ETML-ES-SLO/PRJ_2407_CmdFrigo/doc/Annexes/Annexe B/2707_Planification.pdf

Tâches | Détails

Cahier des charges et planification

Pré-étude | Choix de la gache

Gestion des affichages

Choix du microcontrôleur

Choix des modules wifi et ehternet

Choix de l'affichage

Choix du module RFID

Schéma électrique

PCB

Boîtier

Software | Renseignements

Estimation de la consommation

Assemblage

Tests et mise au point

Rédaction du rapport

Commande de la gache

Lecture badge RFID

Communication Wi-Fi

Lecture batterie

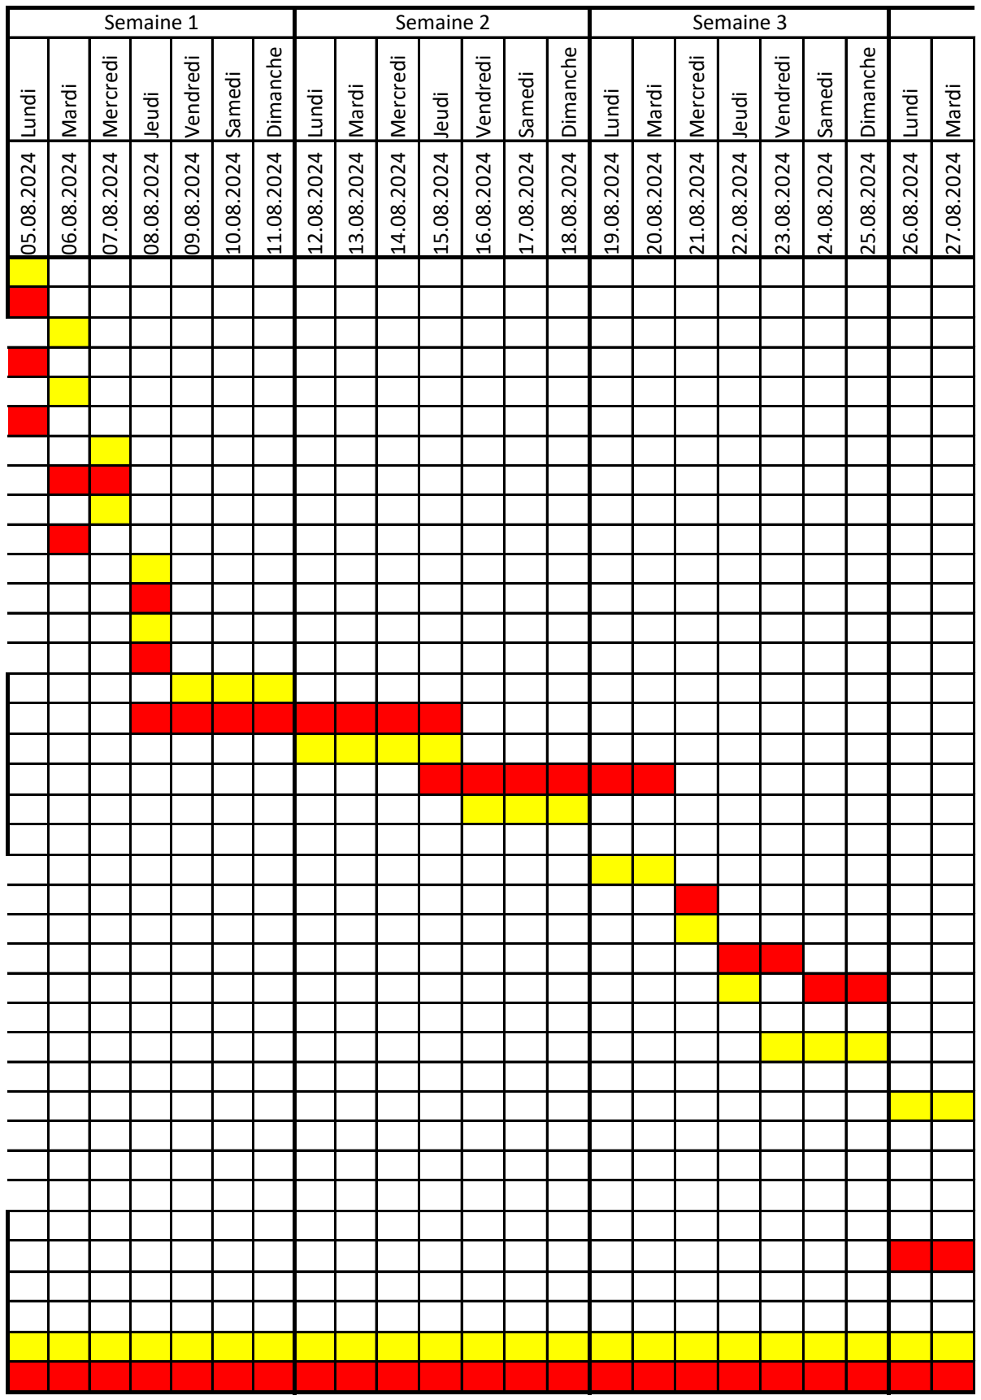
[picture p1: figure]
Lundi; Mardi; Mercredi; Jeudi; Vendredi; Samedi; Dimanche; Semaine 1; Semaine 2; Semaine 3

Réalisé

Planifié

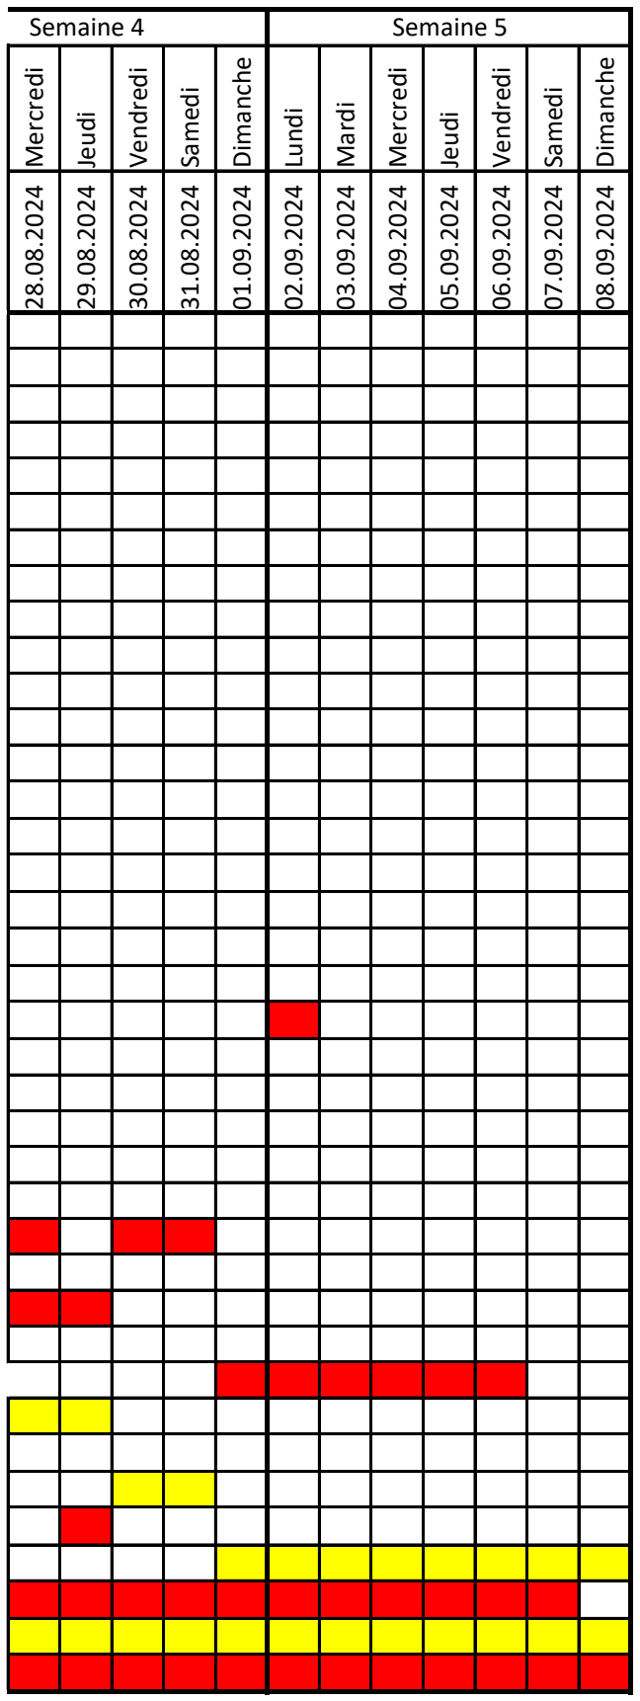
[picture p2: figure]
Mercredi; Jeudi; Vendredi; Samedi; Dimanche; Lundi; Mardi; Semaine 4; Semaine 5
