ETML-ES-SLO/PRJ_2407_CmdFrigo/doc/Annexes/Annexe D/PV_210824 .pdf

PV de séance | diplôme

Ecole supérieure, école des métiers Lausanne
Rue de Sébeillon 12
CH-1004 Lausanne | www.etml.ch
PV_210824 .docx | | 1 / 2 |

## Procès-verbal du 21.08.2024

Présents

- | M. Bovey | (PBY)
- | M. Do Carmo | (ADC)

État des lieux

- Revue de PCB effectuée Lundi 19.08.2024
- Design du PCB fini :
- Corrections sur le schéma (driver de gate ajouté + alim 3,3V corrigée)
- BOM finie
- Commande des composants effectuée
- Commande du PCB effectuée
- Rapport :
- Pré-étude finie
- Schéma presque fini

Problèmes rencontrés

- Rapport :
- Question sur le ratio pour la fin de charge de l’accu
- Pourquoi des résistances 5k1 sur l’USB-C ? Norme ?

Solutions proposées

Décisions prises

- Rapport :
- La tension de l'accu a atteint sa tension nominal - système de limitation du courant - car l'accu se charge que le courant décroit
- Documentation (https://www.microchip.com/content/dam/mchp/documents/OTH/ApplicationNotes/ApplicationNotes/00001914B.pdf) sur l’USB-C trouvée

Suite du projet / objectifs - jusqu’au 28 août

- Structogrammes et machine d’état
- Réaliser le pining du microcontrôleur
- Paramétrer les différents drivers
- Importer les librairies
- Commencer le code

ETML⁻ES

PV_210824 .docx | 30.08.2024 - page 2 / 2

Prochaine réunion:

23.08.2024, 11h30, Salle R110 ETML-ES | Revue code
28.08.2024, 09h00, Salle R110 ETML-ES | Séance classique

Destinataires de ce PV

- Grégoire Rossier, Doyen de l’ETML-ES
- Philippe Bovey, Maître de diplôme

Lausanne le 22.08.2024

Antonio Do Carmo
