ETML-ES-SLO/PRJ_2407_CmdFrigo/doc/Annexes/Annexe D/PV_300824 .pdf

PV de séance | diplôme

Ecole supérieure, école des métiers Lausanne
Rue de Sébeillon 12
CH-1004 Lausanne | www.etml.ch
PV_300824 .docx | | 1 / 2 |

## Procès-verbal du 30.08.2024

Présents

- | M. Bovey | (PBY)
- | M. Do Carmo | (ADC)

État des lieux

- Début du code :
- Pining et configuration
- Diagramme d’états
- Fonction lecture de la batterie
- Fonction ouverture de la gâche
- PCB reçu et assemblé
- Rapport :
- Pré-étude finie
- Schéma fini

Problèmes rencontrés

- Support d’accu pas adapté

Solutions proposées

- Commencer le soft en alimentant via l’alim de labo

Décisions prises

Suite du projet / objectifs - jusqu’au 4 septembre

- Structogrammes et amélioration machine d’état
- Finaliser le code (RFID, Wi-Fi, I/O Expander, …)
- Concevoir le boîtier

Prochaine réunion:

02.09.2024, 11h30, Salle R110 ETML-ES | Revue code
04.08.2024, 09h00, Salle R110 ETML-ES | Séance classique

ETML⁻ES

PV_300824 .docx | 03.09.2024 - page 2 / 2

Destinataires de ce PV

- Grégoire Rossier, Doyen de l’ETML-ES
- Philippe Bovey, Maître de diplôme

Lausanne le 28.08.2024

Antonio Do Carmo
