ETML-ES-SLO/PRJ_2407_CmdFrigo/doc/Annexes/Annexe J/Mode d'emploi.pdf

## Ecole supérieure

Électronique

ETML-ES
Salle R110

# Diplôme - 2407 Commande Ouverture Frigo

# Mode d’emploi

Réalisé par :

Antonio Do Carmo

Étape 1 :

Insérer les accumulateurs dans le support prévu à cet effet

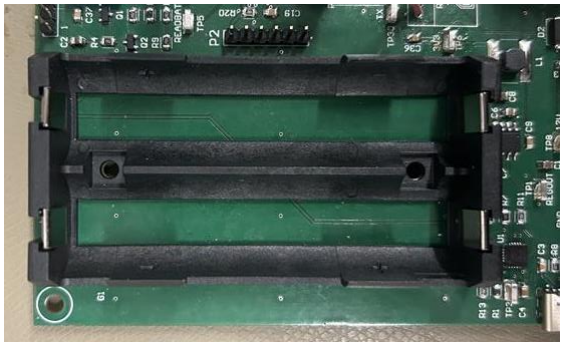
[picture p3: figure]

Étape 2 :

Brancher le module RFID, le LCD et la gâche au circuit

Étape 3 :

Refermer le boîtier

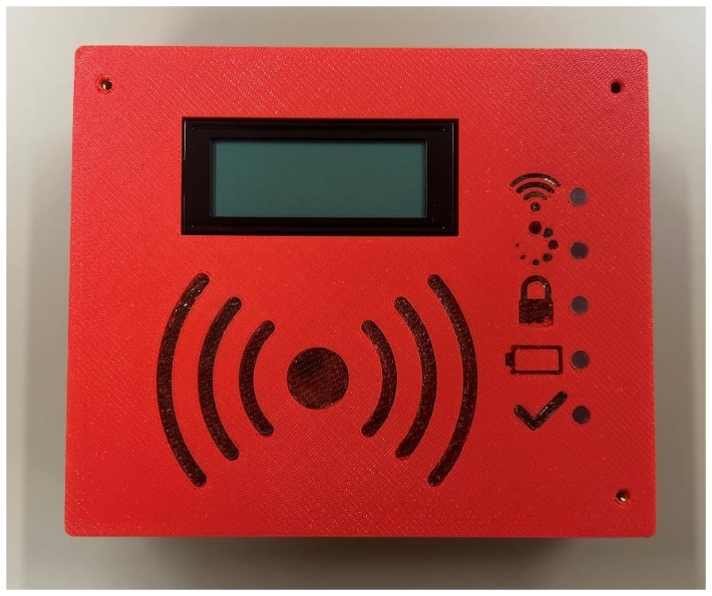
[picture p4: figure]

Étape 4 :

Placer le boîtier et la gâche sur la porte du frigo

Étape 5 :

Passer le badge RFID sur la surface du boîtier comportant le logo RFID afin d’ouvrir la porte
