ETML-ES-SLO/PRJ_2407_CmdFrigo/doc/Annexes/Annexe H/Schéma de mesures diplôme.png

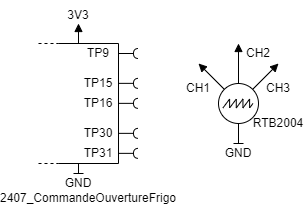
doc/Annexes/Annexe H/Schéma de mesures diplôme.png
