ETML-ES-SLO/PRJ_2407_CmdFrigo/doc/Annexes/Annexe L/duree gache.png

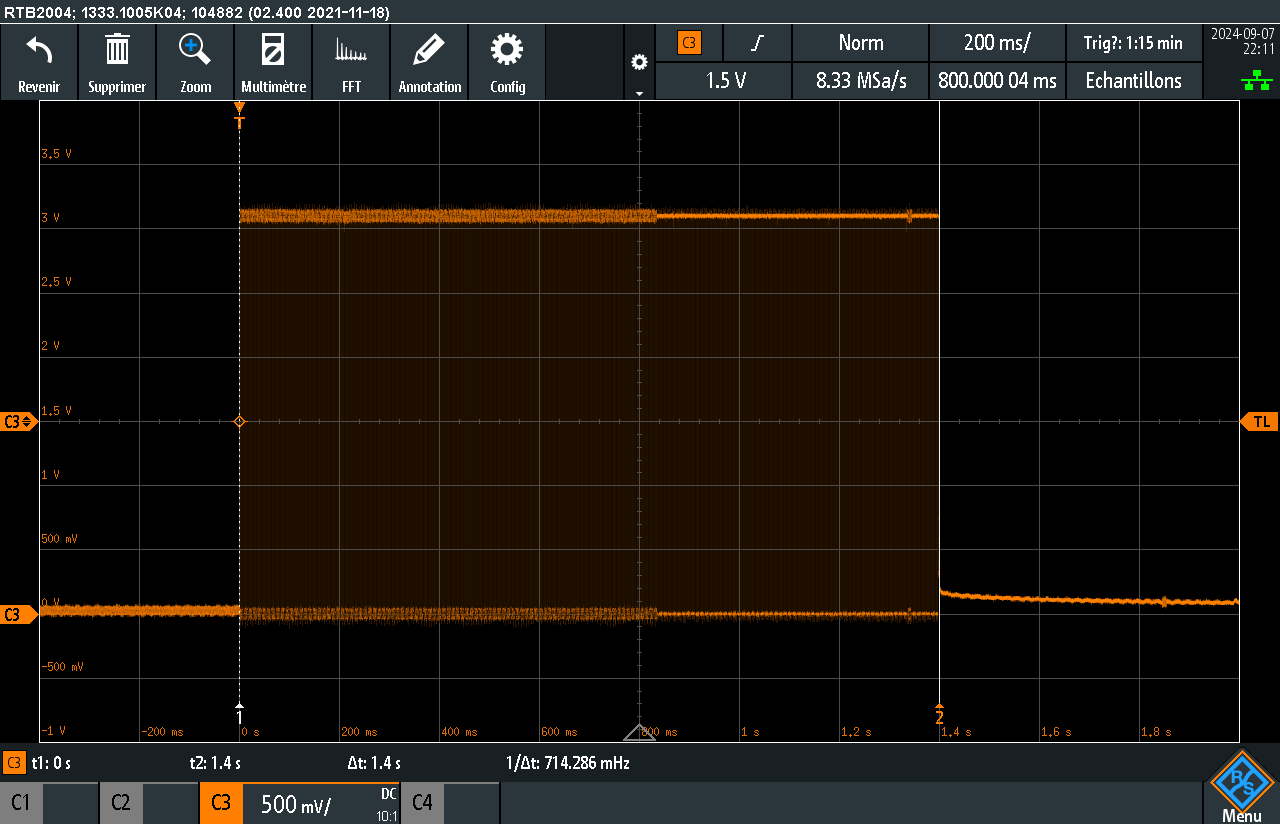
doc/Annexes/Annexe L/duree gache.png
