ETML-ES-SLO/PRJ_2407_CmdFrigo/doc/Annexes/Annexe L/gache 3V5.png

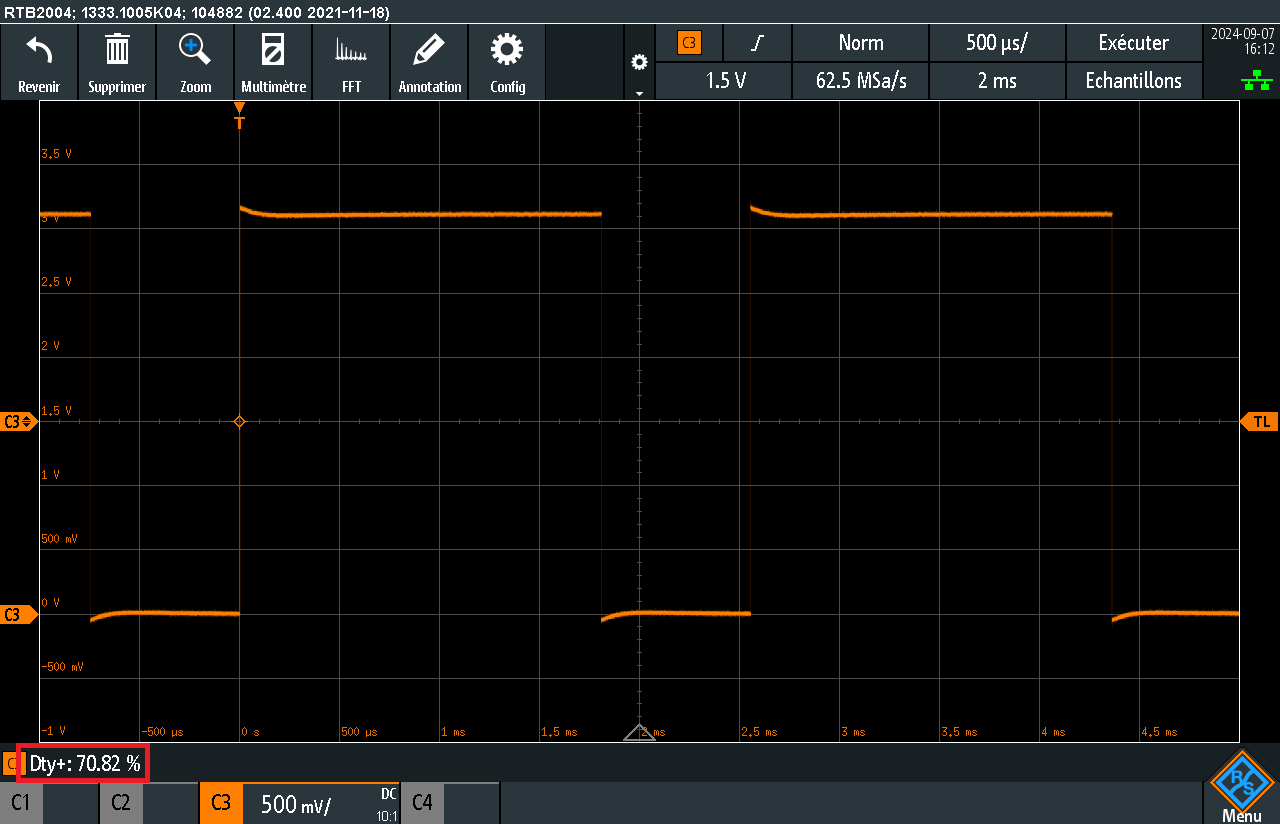
doc/Annexes/Annexe L/gache 3V5.png
