ETML-ES-SLO/PRJ_2407_CmdFrigo/doc/Annexes/Annexe L/I2C.png

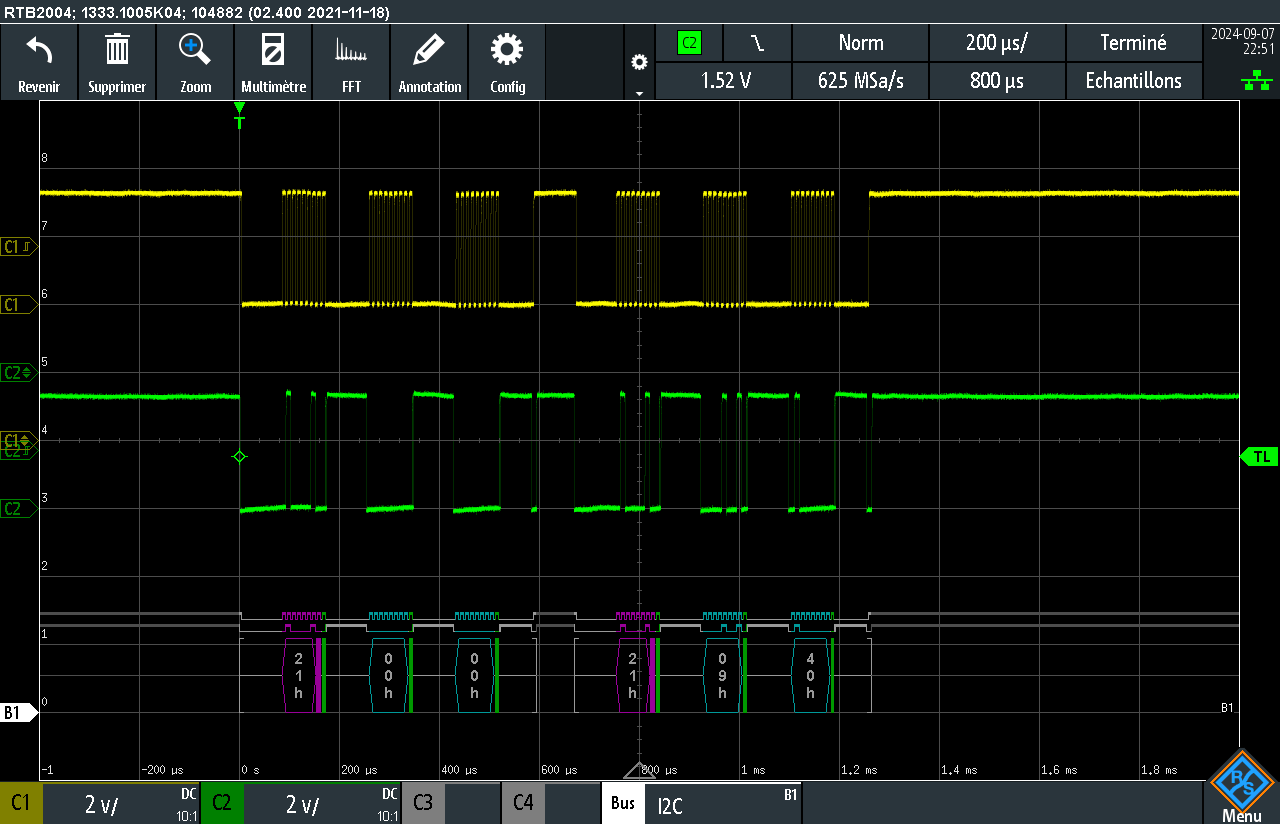
doc/Annexes/Annexe L/I2C.png
