ETML-ES-SLO/PRJ_2407_CmdFrigo/doc/Annexes/Annexe L/Polling.png

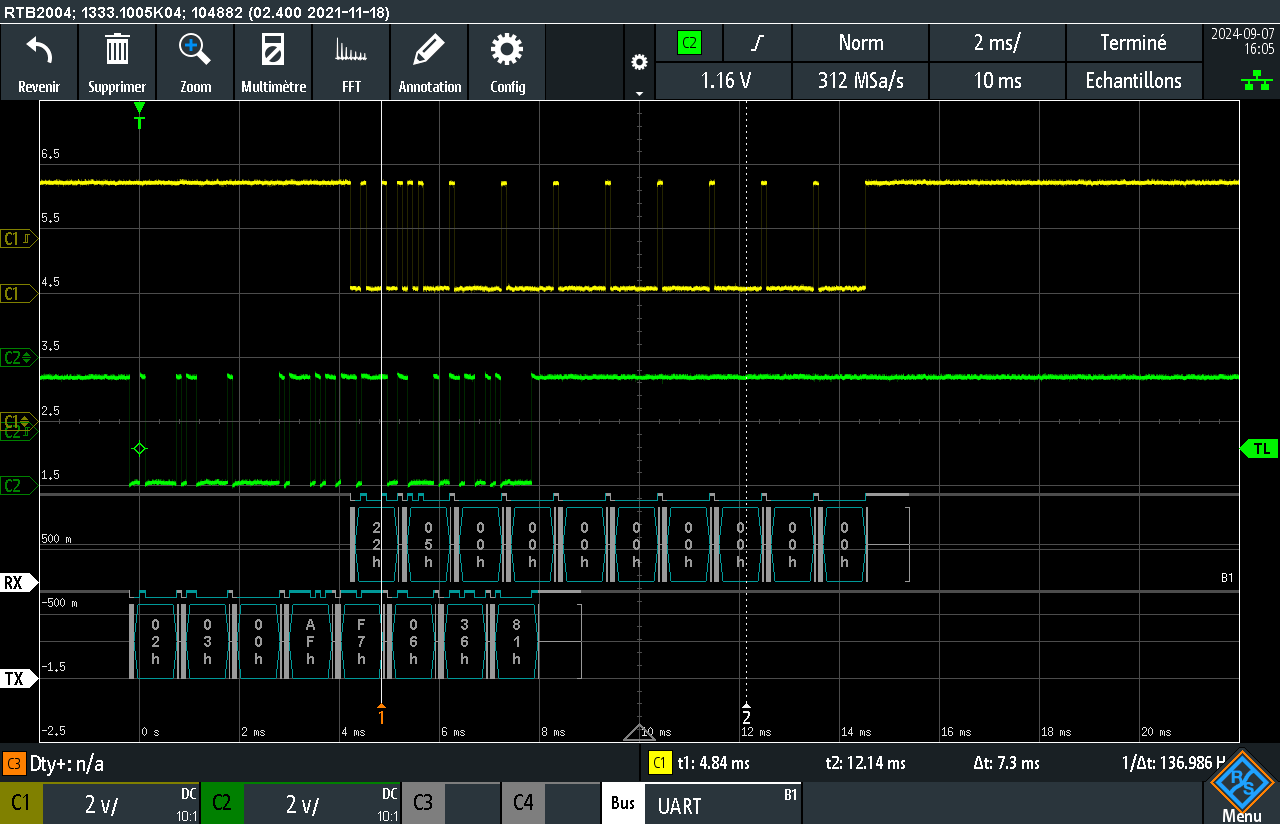
doc/Annexes/Annexe L/Polling.png
