ETML-ES-SLO/PRJ_2407_CmdFrigo/doc/Annexes/Annexe L/RFID_UID.png

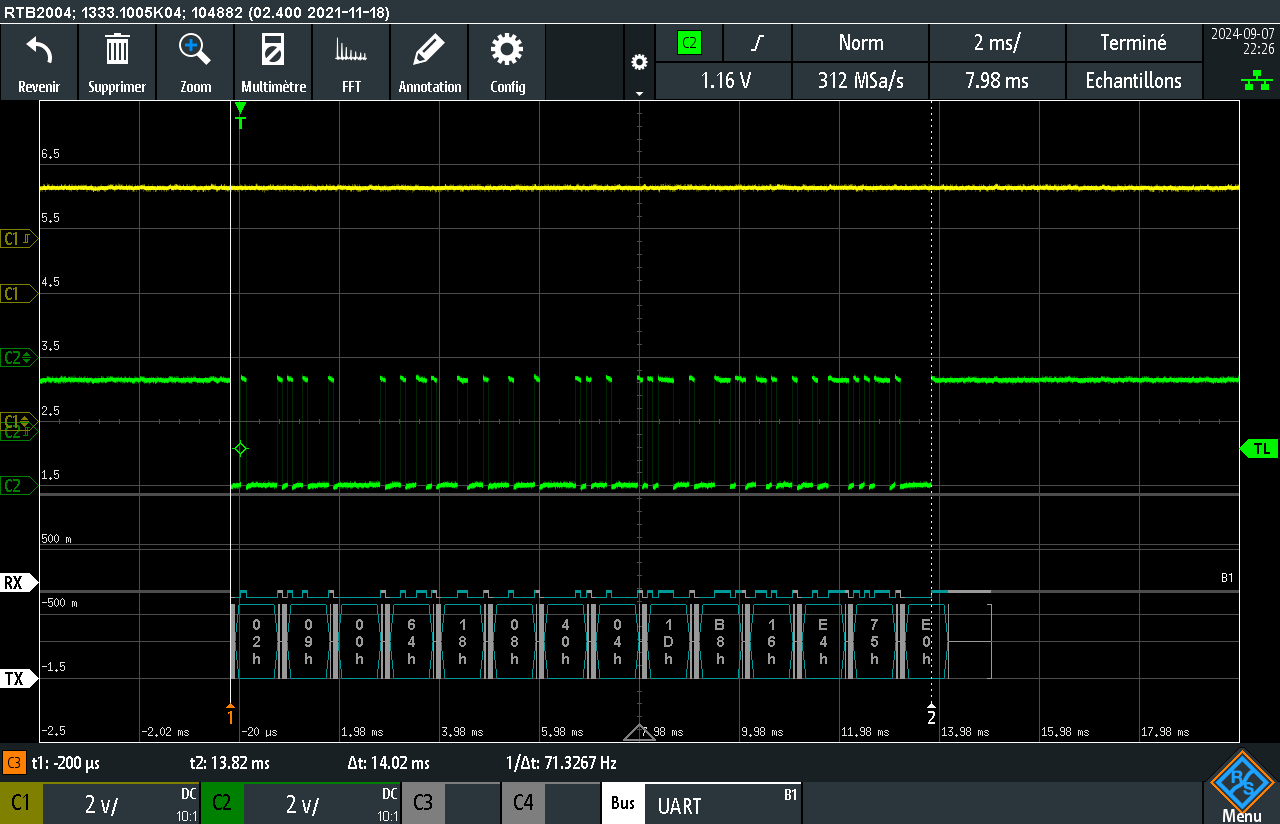
doc/Annexes/Annexe L/RFID_UID.png
