ETML-ES-SLO/PRJ_2407_CmdFrigo/mec/Couvercle boitier.SLDPRT

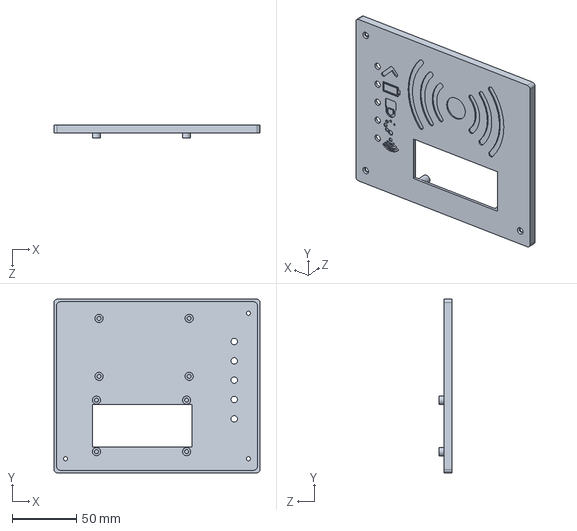
[picture p11: CAD file, 2024-09-09]
mec/Couvercle boitier.SLDPRT
160.0 x 135.0 x 10.0 mm
