ETML-ES-SLO/PRJ_2407_CmdFrigo/mec/NHD-0420AZ.STEP

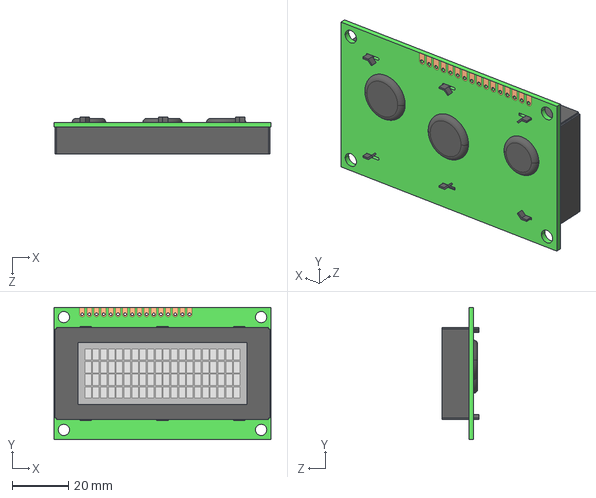
[picture p12: CAD file, 2024-09-09]
mec/NHD-0420AZ.STEP
77.0 x 47.0 x 13.0 mm
