ETML-ES-SLO/PRJ_2407_CmdFrigo/mec/Boitier base.SLDPRT

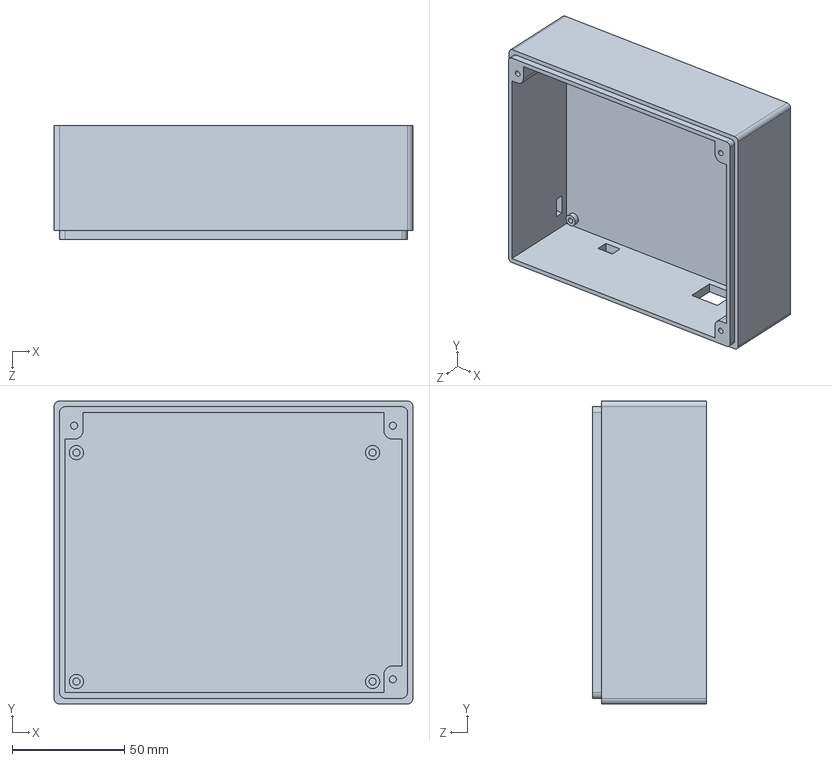
[picture p13: CAD file, 2024-09-09]
mec/Boitier base.SLDPRT
160.0 x 135.0 x 51.0 mm
