ETML-ES-SLO/PRJ_2407_CmdFrigo/mec/iso_2009_m3_x_20.SLDPRT

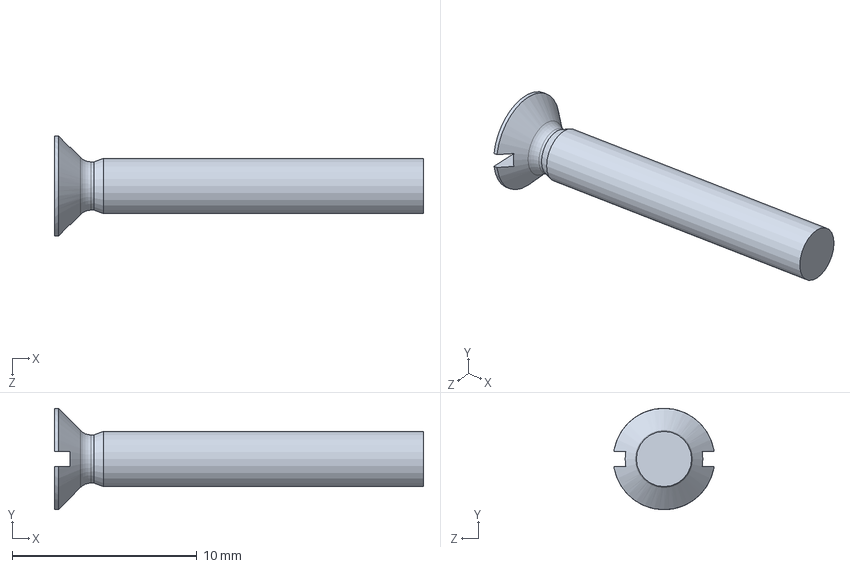
[picture p14: CAD file, 2024-09-09]
mec/iso_2009_m3_x_20.SLDPRT
20.0 x 5.50 x 5.44 mm
