ETML-ES-SLO/PRJ_2407_CmdFrigo/mec/1474370.SLDPRT

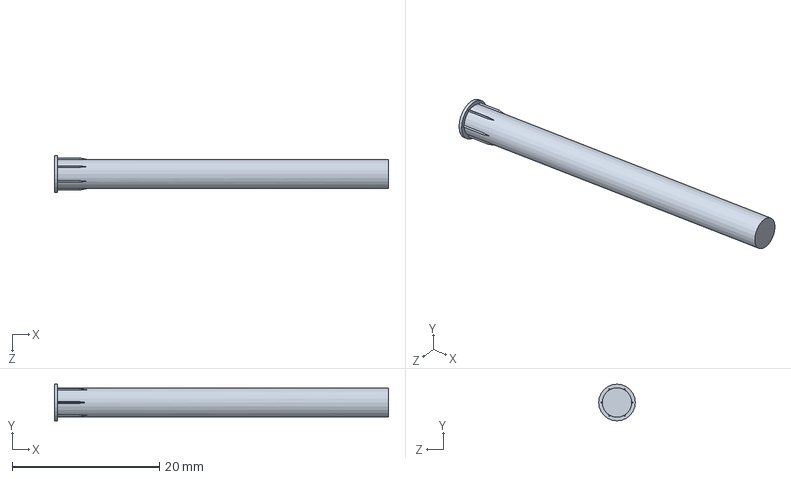
[picture p15: CAD file, 2024-09-09]
mec/1474370.SLDPRT
45.4 x 5.00 x 5.00 mm
