ETML-ES-SLO/PRJ_2407_CmdFrigo/(list of files, cad)

Other CAD files:
mec/Boitier base.SLDDRW
mec/Couvercle boitier.SLDDRW
