ETML-ES-SLO/PRJ_2407_CmdFrigo/doc/Annexes/Annexe C/2407_Journal_de_travail.pdf

Date | Début | Fin | Durée
05.08.2024 | 10h00 | 11h15 | 1h15
05.08.2024 | 11h15 | 11h50 | 0h35
05.08.2024 | 11h50 | 12h00 | 0h10
05.08.2024 | 12h50 | 13h50 | 1h00
05.08.2024 | 13h50 | 14h10 | 0h20
05.08.2024 | 14h10 | 14h20 | 0h10
05.08.2024 | 14h20 | 14h40 | 0h20
05.08.2024 | 14h40 | 15h30 | 0h50
05.08.2024 | 15h30 | 19h00 | 3h30
05.08.2024 | 19h00 | 20h00 | 1h00
06.08.2024 | 8h40 | 9h40 | 1h00
06.08.2024 | 9h40 | 10h00 | 0h20
06.08.2024 | 10h00 | 10h20 | 0h20
06.08.2024 | 10h20 | 11h30 | 0h50
06.08.2024 | 12h30 | 14h10 | 1h40
06.08.2024 | 14h10 | 14h30 | 0h20
06.08.2024 | 14h30 | 15h30 | 1h00
06.08.2024 | 15h30 | 16h10 | 0h40
06.08.2024 | 16h10 | 17h00 | 0h50
07.08.2024 | 8h30 | 10h00 | 1h30
07.08.2024 | 10h00 | 10h40 | 0h40
07.08.2024 | 10h40 | 11h00 | 0h20
07.08.2024 | 11h00 | 11h30 | 0h30
07.08.2024 | 13h00 | 13h20 | 0h20
07.08.2024 | 13h20 | 16h30 | 3h10
07.08.2024 | 16h30 | 17h20 | 0h50
07.08.2024 | 17h20 | 18h20 | 1h00
07.08.2024 | 18h20 | 19h00 | 0h40
08.08.2024 | 8h45 | 10h00 | 1h15
08.08.2024 | 10h00 | 11h30 | 1h30
08.08.2024 | 12h20 | 14h10 | 1h50

08.08.2024 | 14h10 | 14h50 | 0h40
08.08.2024 | 14h50 | 15h00 | 0h10
08.08.2024 | 15h00 | 18h00 | 3h00
09.08.2024 | 8h40 | 11h30 | 2h50
09.08.2024 | 12h30 | 13h40 | 1h10
09.08.2024 | 13h40 | 16h30 | 2h50
11.08.2024 | 15h00 | 19h00 | 4h00
12.08.2024 | 8h40 | 9h10 | 0h30
12.08.2024 | 9h10 | 10h40 | 1h30
12.08.2024 | 10h40 | 11h40 | 1h00
12.08.2024 | 12h30 | 20h30 | 8h00
13.08.2024 | 8h40 | 9h40 | 1h
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
Design du PCB
Design du PCB
Design du PCB
Design du PCB
Discussion avec M.Moreno
Design du PCB
Software
Software
Software

Software

Software
Software
Schéma électrique
Visite de l'expert

Software

Software

Hardware
Mesures
Hardware
Hardware
Hardware
Software
Discussion avec M.Bovey

Software

Software
Hardware
Software
Software
Software
Discussion avec M.Bovey
Software
Software
Discussion avec M.Bovey
Software
Software
Software
Software
Rapport de projet
Software
Discussion avec M.Bovey
Software
Software
Software
Rapport de projet
Modifications
Software
Mesures
Rapport de projet
Rapport de projet
Rapport de projet
Rapport de projet
Rapport de projet

Détails

Cahier des charges, grille d'évaluation, etc Création du projet Altium
Planification, journal de travail, rapport

Précisions sur le cahier des charges + questions

Planification
Par M.Moreno
Planification

Choix de la gache

Recherche de modules Wi-Fi et Ethernet

Lecture de la documentation sur le RFID

Lecture du rapport du projet 2312

Recherche d'un affichage

Tentative de lecture des badges RFID fournis

Rédaction du rapport avec les composants choisis

Tentative de lecture des badges RFID fournis

Rédaction du rapport avec les composants choisis Préparation du word pour le PV du landemain Rédaction du rapport avec les composants choisis Rédaction de l'introduction du rapport Séance de pré-étude
PV du 07.08.2024
Tableau comparatif des gâches Corrections du PV
Schéma bloc du système

Recherche d'un nouveau LCD

Rédaction des chapitres sur les différents composants Ajout du système de recharge et de lecture de l'accumulateur sur le schéma bloc
Choix du microcontrôleur
Chronogramme ouverture

Estimation de la consommation

Début du schéma électrique
Au sujet de l'estimation de la consommation Blocs microcontrôleur, Alimentation, Affichage Footprints + modèles 3D
Footprints + modèles 3D

Rédaction des chapitres sur les différents composants Rédaction des chapitres sur les différents composants Avec M.Bovey

Finalisation des blocs Wifi, Ethernet, Affichage, Alimentation

Tests de tension et courant sur la gache

Finalisation des blocs Wifi, Ethernet, Affichage, Alimentation

Recherche d'un I/O expander Fin du schéma électrique
Vérifications du schéma avec JAR Ajout des composants sur saphir Corrections du schéma
Début du layout du PCB
Layout du PCB
A propos du Layout
Début du layout du PCB
Fin du layout PCB
Début du routage
Routage du PCB
Routage du PCB
Revue du PCB
Routage du PCB
Routage du PCB
Routage du PCB
Finalisation du PCB
Revue du PCB
Finalisation du PCB et commande Pining et configuration
Lecture de la batterie
Lecture de la batterie

Fonction de lecture de la batterie et d'ouverture de la gâche

Lecture de la doc et des librairies Lecture de la doc et des librairies Avancement sur le rapport de diplôme Séance avec M.Yersin

Fonction de lecture de la batterie et d'ouverture de la gâche

Fonction de lecture de la batterie et d'ouverture de la gâche

Assemblage du PCB
Test de l'alimentation
Assemblage du PCB
Assemblage du PCB
Assemblage du PCB
Tests programmation sur la carte Séance rapide

Fonction de lecture de la batterie et d'ouverture de la gâche

Fonction de lecture de la batterie et d'ouverture de la gâche Câblage du LCD
Fonction pour le LCD
Fonction pour l'I/O Expander Fonction pour l'I/O Expander Séance classique
Fonction pour l'I/O Expander Fonction pour l'I/O Expander Séance rapide
Fonction pour le RFID
Fonction pour le RFID
Fonction pour le RFID
Fonction pour le RFID
Suite du rapport
Fonction pour le RFID
Séance rapide
Fonction pour le RFID
Programmation de l'ESP32
Fonction pour le RFID
Suite du rapport
Modificatios DC-DC12V et assemblage boîtier Fonction pour le RFID
Mesures des différentes trames Suite du rapport
Suite du rapport
Suite du rapport
Suite du rapport
Fin du rapport

Problèmes

1) Possible d'avoir le matériel du TP RFID?
2) Mise à disposition de la glacière?
3) Présence des enseignants?
3) Quand est la 1ère séance, que préparer?

Les gaches magnétiques classiques nécéssitent une grande puissance et sont en fonctionnement permanent
=> Pas possible de les faire fonctionner sur batterie et facilement bypassable en débranchant le boîtier du secteur

Impossible de les lire avec le kit de l'ES et avec des applications dédiées sur smartphone

Voir PV de la séance

Le LCD choisi précédemment doit être alimenté en 5V mais tout le reste de mon circuit fonctionne en 3.3V

Batterie 3400 mAh semble insuffisante => voir avec M.Bovey

Pas assez de pins sur le uC

Inductance trop grosse

ADC illisible

Carte illisible -> badge de l'ES lisible

Solutions

1) Oui (donné)
2) Mercredi lors de la séance
3) Horaires donnés par email
4) Mercredi / canevas PV, planification, avancement

J'ai trouvé ce modèle de gache (https://www.amazon.fr/%C3%89lectronique-%C3%89lectrique-Sol%C3%A9no%C3%AFde-D%C3%A9tection-Interrupteur/dp/B07B4G6N1K)

J'ai trouvé les modules Wifi Click et ETH Click de chez Mikroe

Mon prédécésseur a utilisé les composants suivants:
- LAN8720A-CP-TR-ABC pour l'Ethernet
- ESP32-C3-WROOM-02-N4 pour le Wi-Fi
- CHILLI UART B1 pour le RFID
Un LCD classique devrait faire l'affaire

A l'aide de l'application Tag Reader j'ai pu lire un des deux badges fournis

Voir PV de la séance

J'ai trouvé ce modèle de LCD (https://www.digikey.ch/fr/products/detail/newhaven-display-intl/NHD-0420AZ-FSW-GBW-33V3/2773596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)

Voir PV

Voir PV
J'ai trouvé ce modèle (https://www.mouser.ch/ProductDetail/Microchip-Technology/MCP23008-E-SO?qs=Sez7gRs8XSWum74ZwQXTLw%3D%3D)

Ne pas fixer le LCD et le module RFID au PCB

Alimentation OK

Microcontrôleur fonctionnel

ADC fonctionnel

LCD fonctionnel

I/O Expander fonctionnel

Voir problèmes de timing pour le RFID
