ETML-ES-SLO/PRJ_2407_CmdFrigo/doc/Annexes/Annexe F/2407_Commande_Ouverture_Frigo_PCB Top-Bot Assy Dwgs_Variant_No Variations.PDF

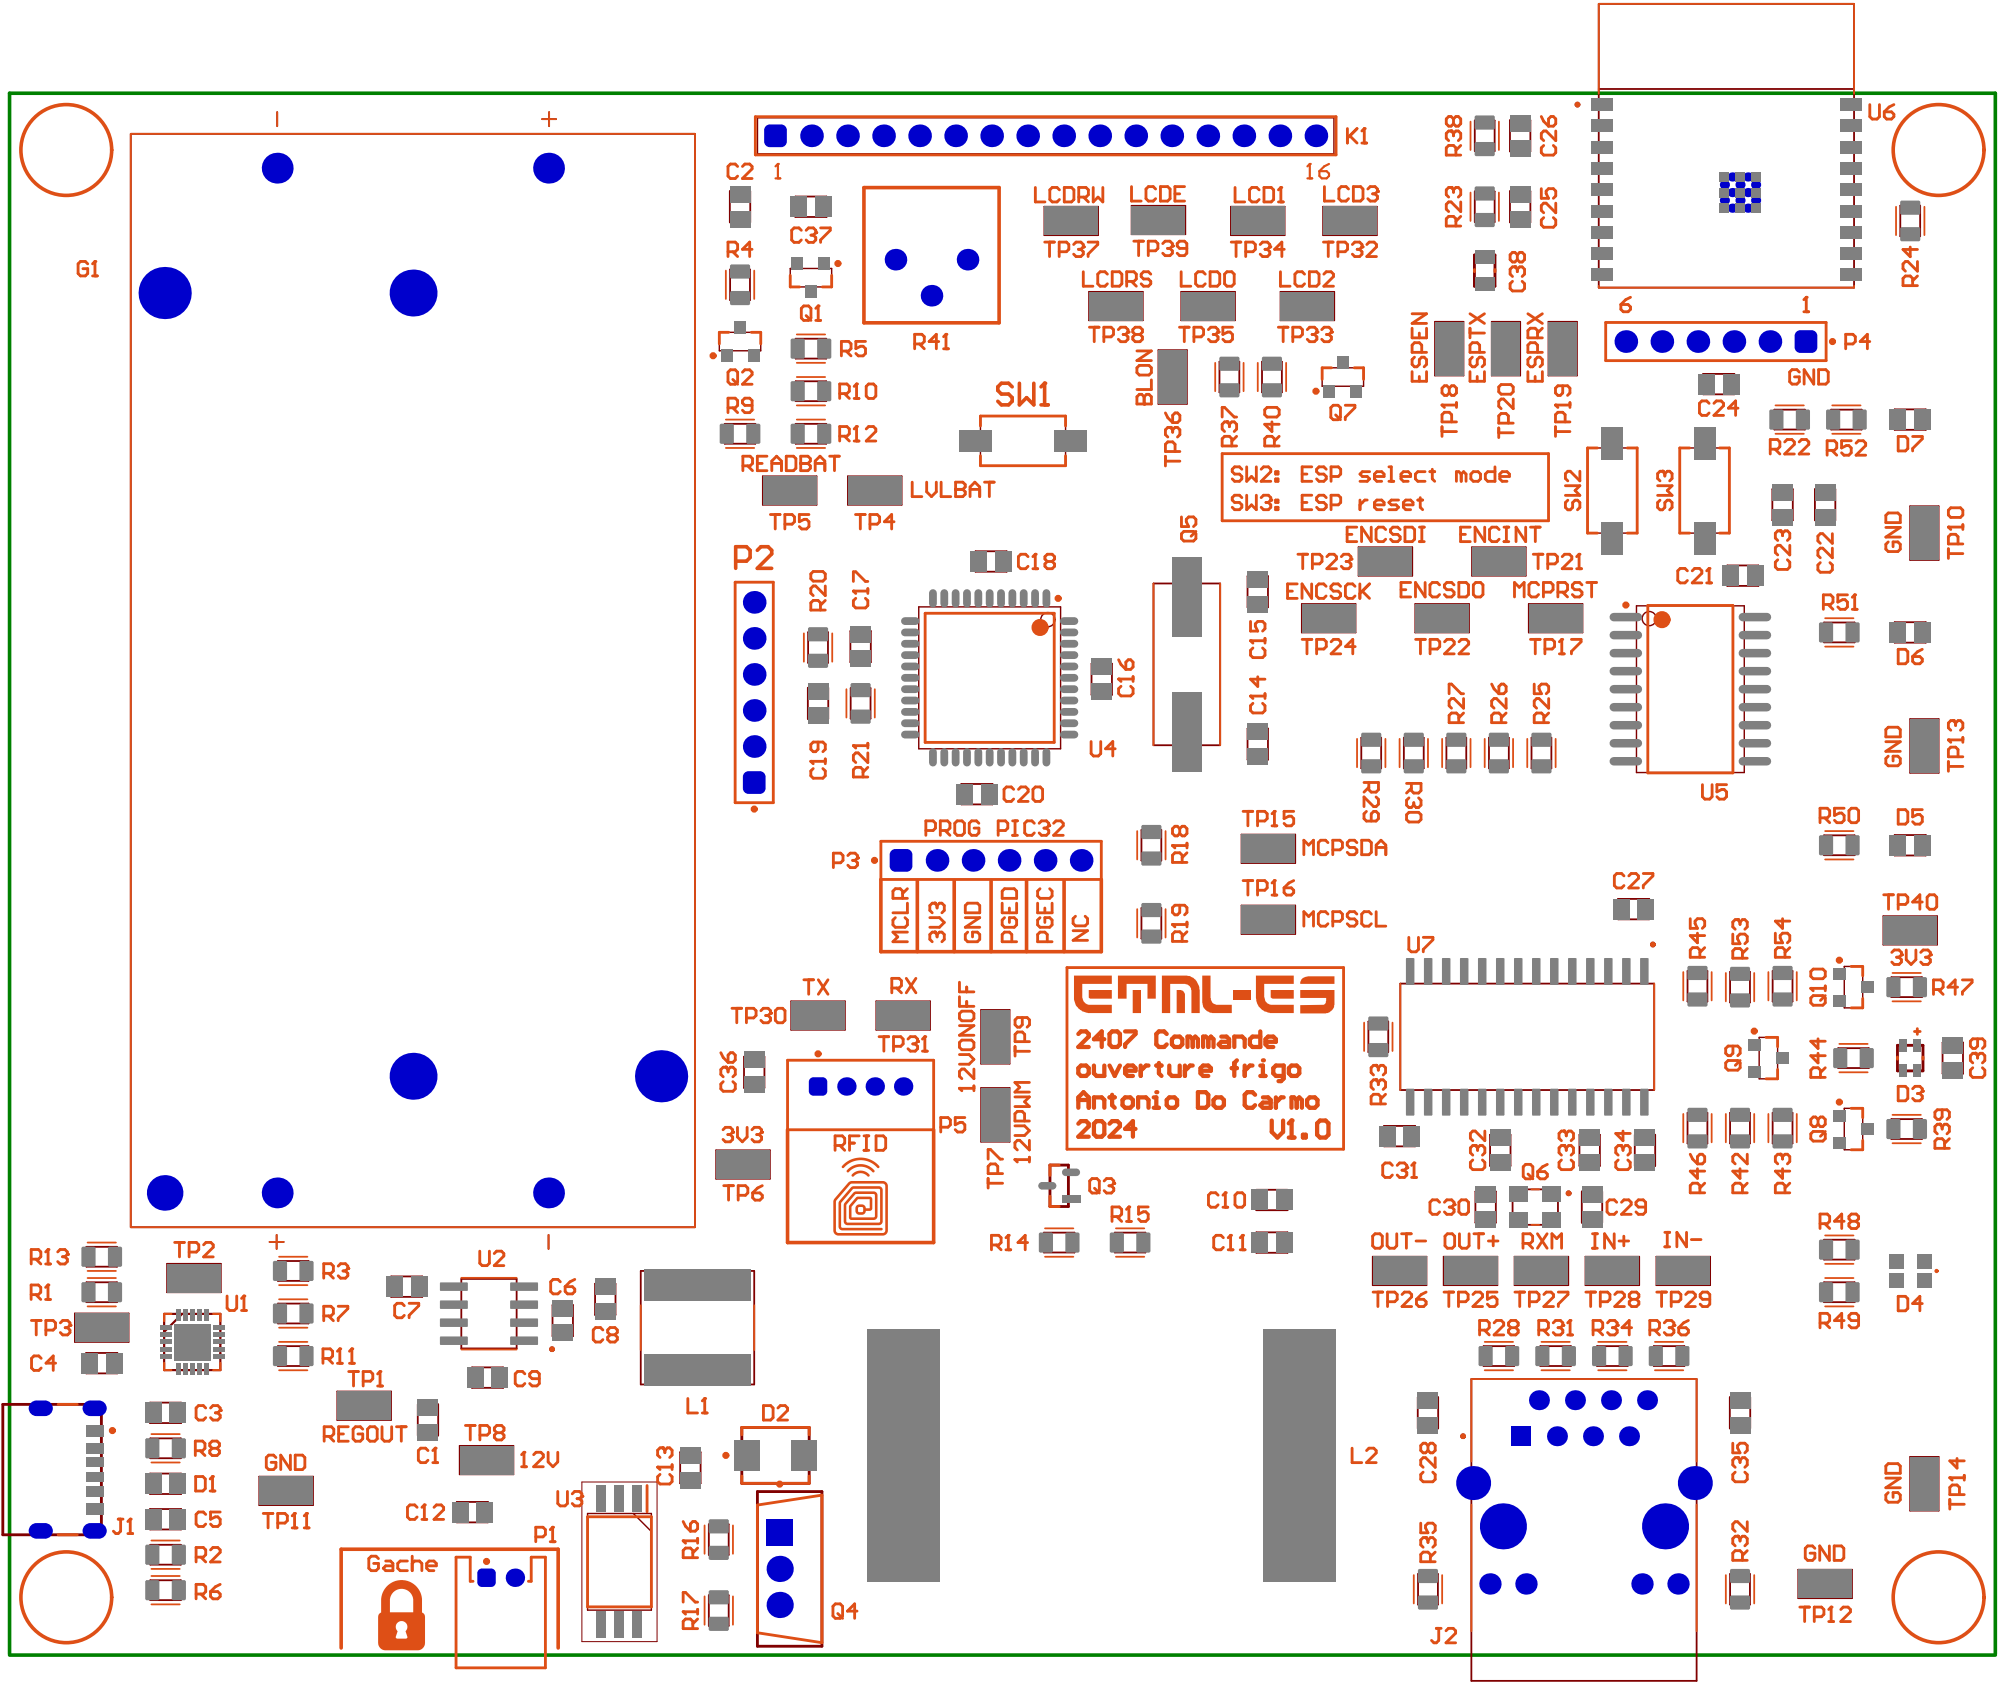
[picture p20: page 1]
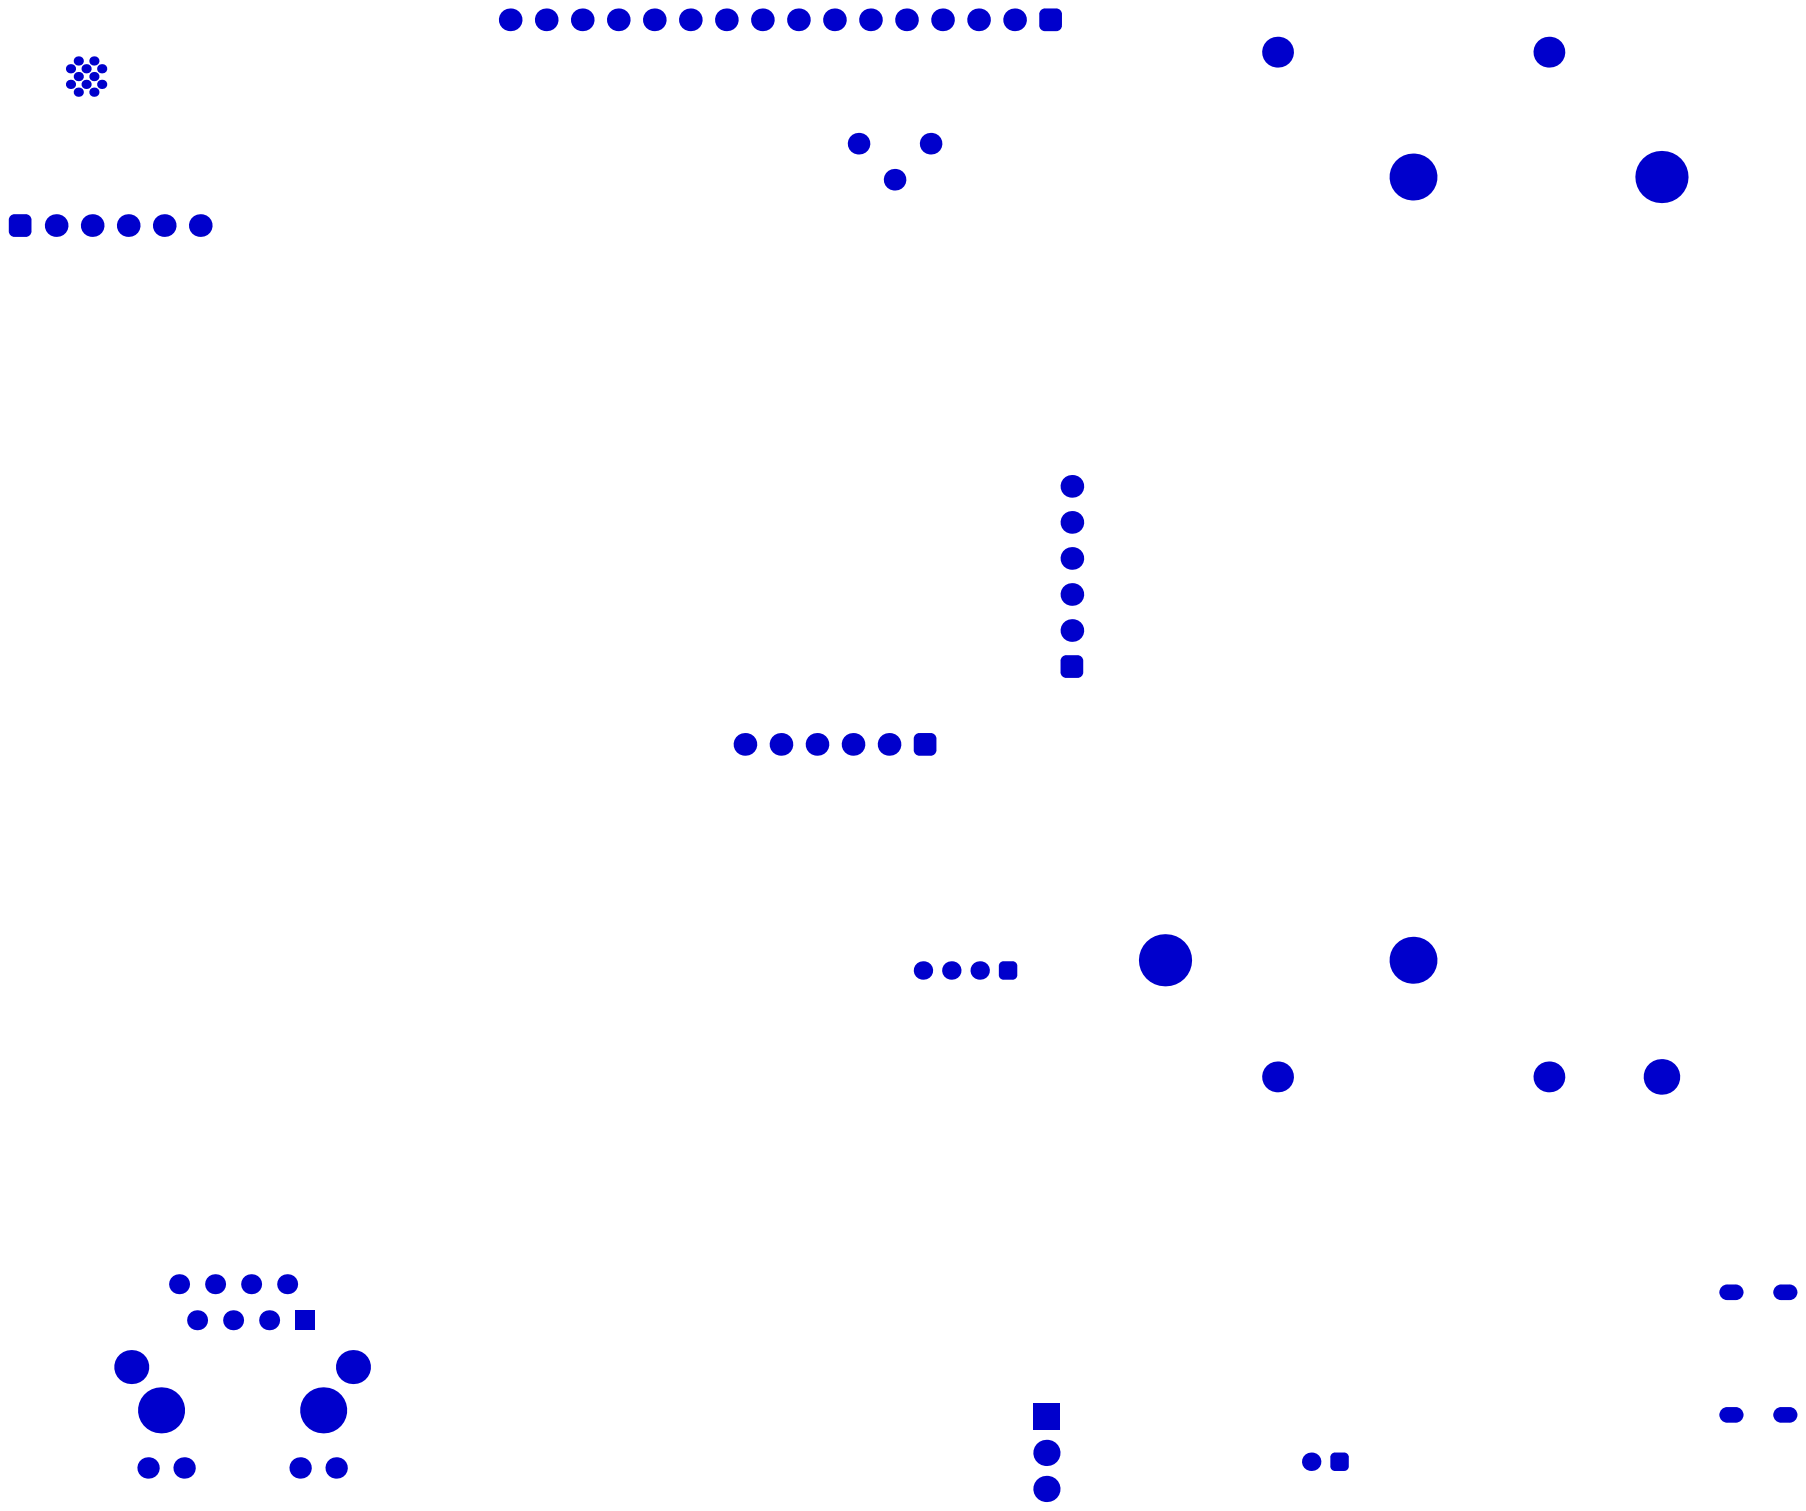
[picture p21: page 2]
