ETML-ES-SLO/PRJ_2407_CmdFrigo/doc/Annexes/Annexe E/2407_Commande_Ouverture_Frigo_Schematic_Variant_No Variations.PDF

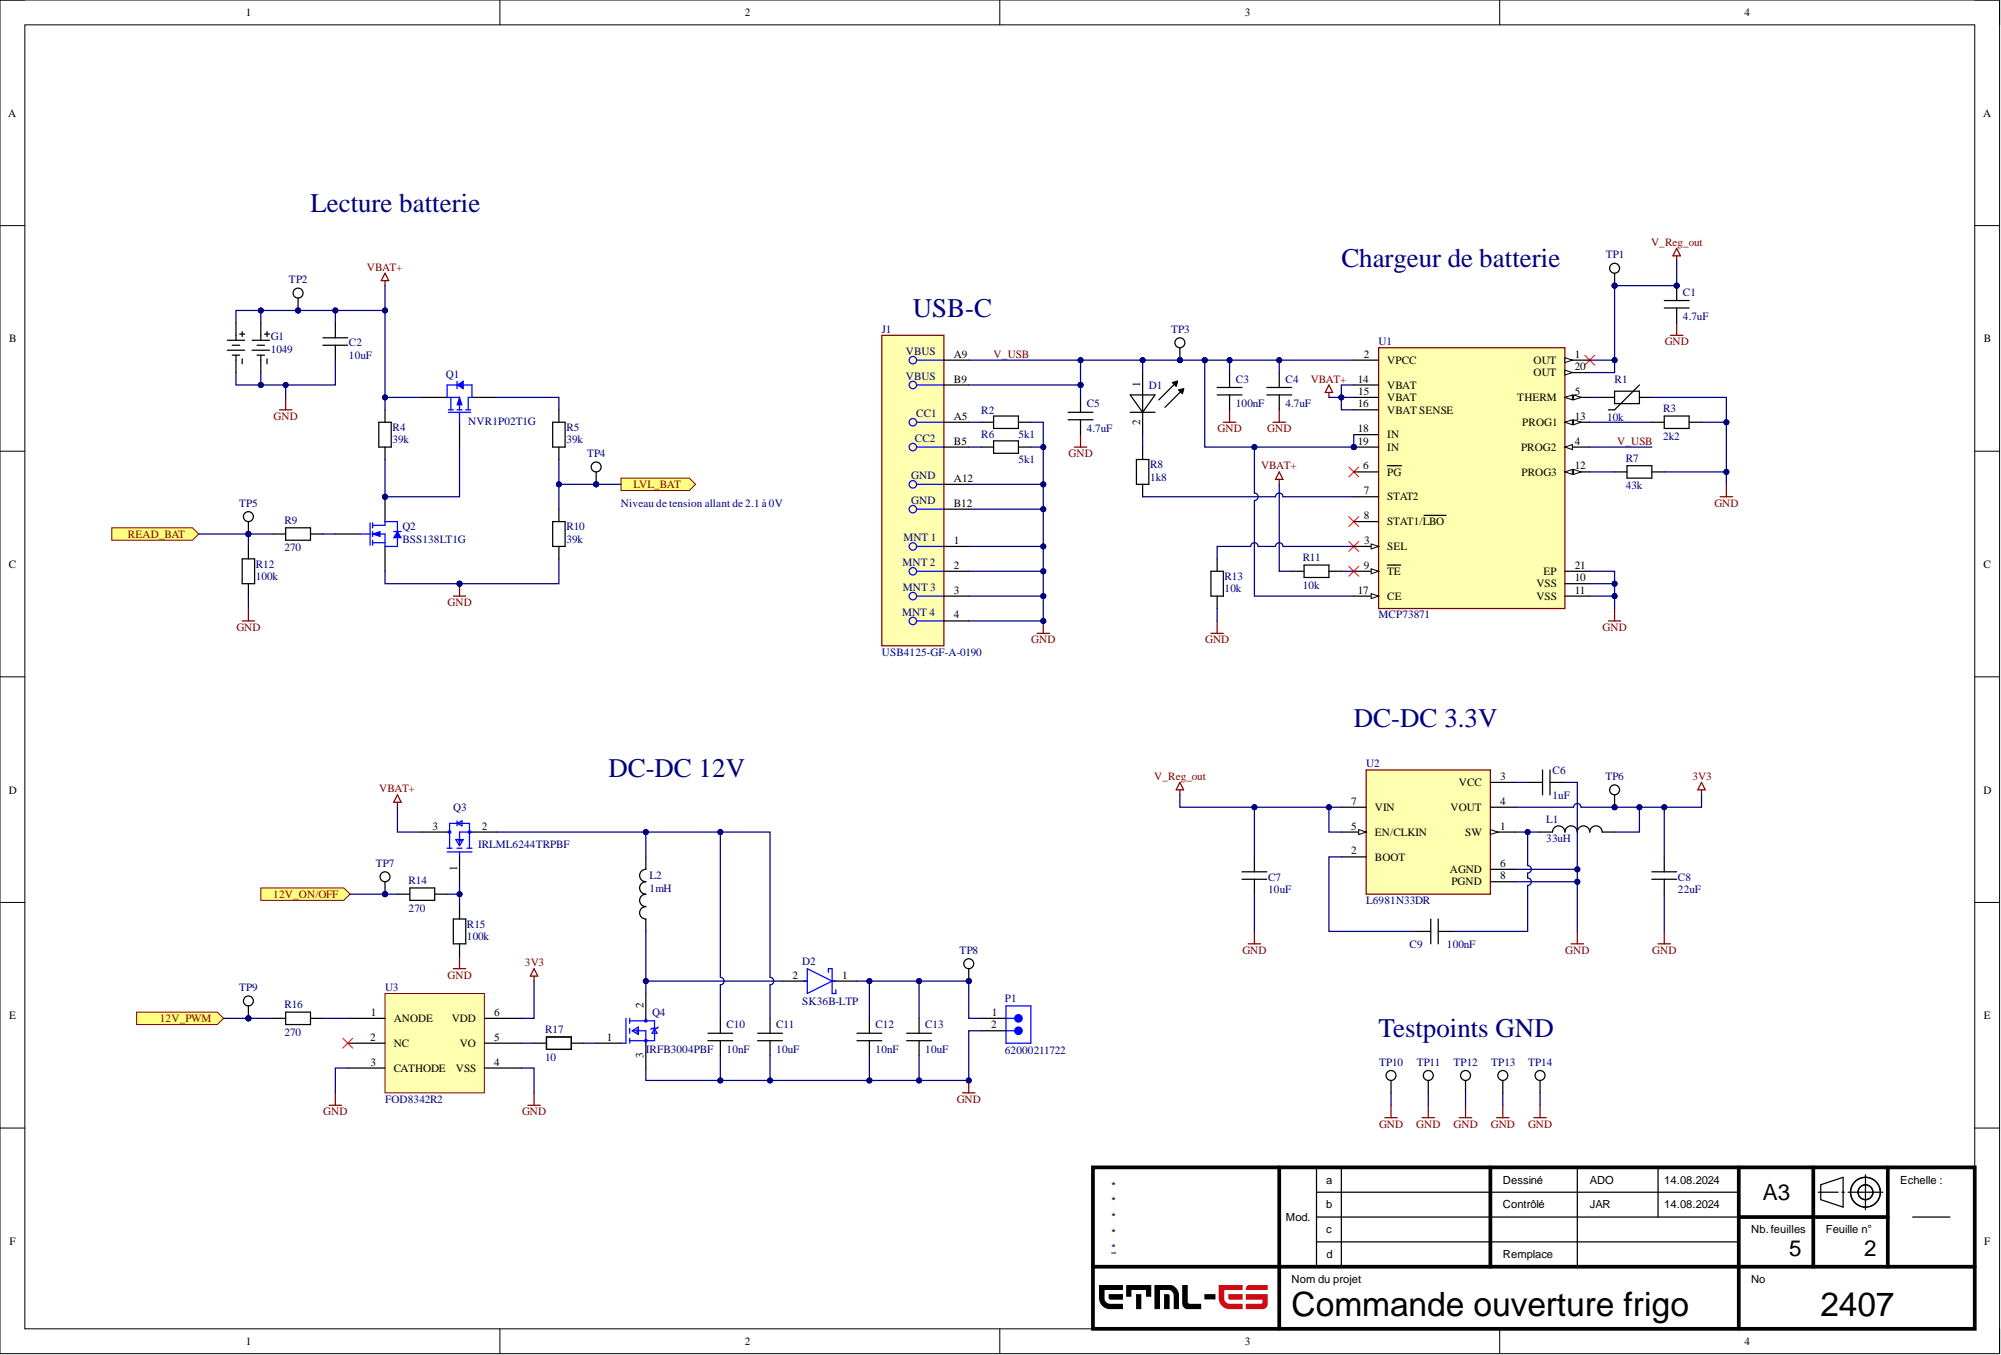
[picture p16: page 1]

LVL_BAT
Niveau de tension allant de 2.1 à 0V

* * * * * | Mod. | a | Dessiné | ADO | 14.08.2024 | A3 | | Echelle :

b | Contrôlé | JAR | 14.08.2024

c | | | | Nb. feuilles 5 | Feuille n° 2

d | Remplace

Nom du projet Commande ouverture frigo | | | | | No 2407

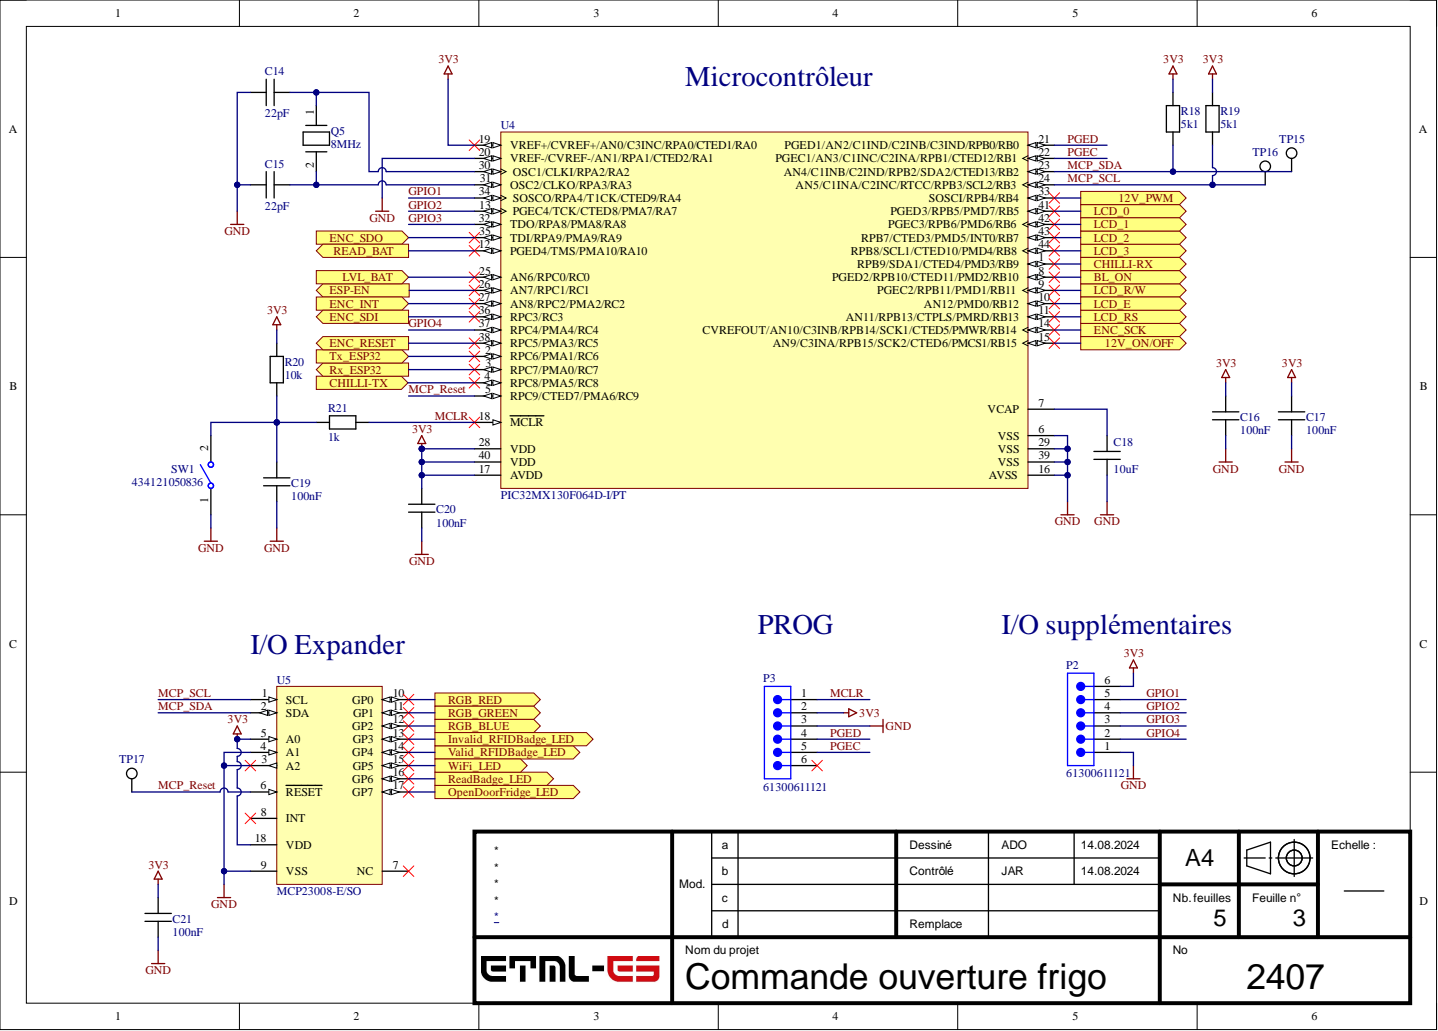
[picture p17: page 2]

3 0 | 2 3 MCP_SD
3 1 | 2 4 MCP_SCL

GPIO 1 | 3 4

2 9

4 0 | 3 9
1 7 | 1 6

** *** | Mod . | | Des s i n é | AD O | 14.08.20 2 4 | A4 | | Echelle :

abcd | Cont r ô l é | J A R | 14.08.20 2 4

Nb. feuilles 5 | Feuille n ° 3

Rempla c e

Nom du projet | | N o

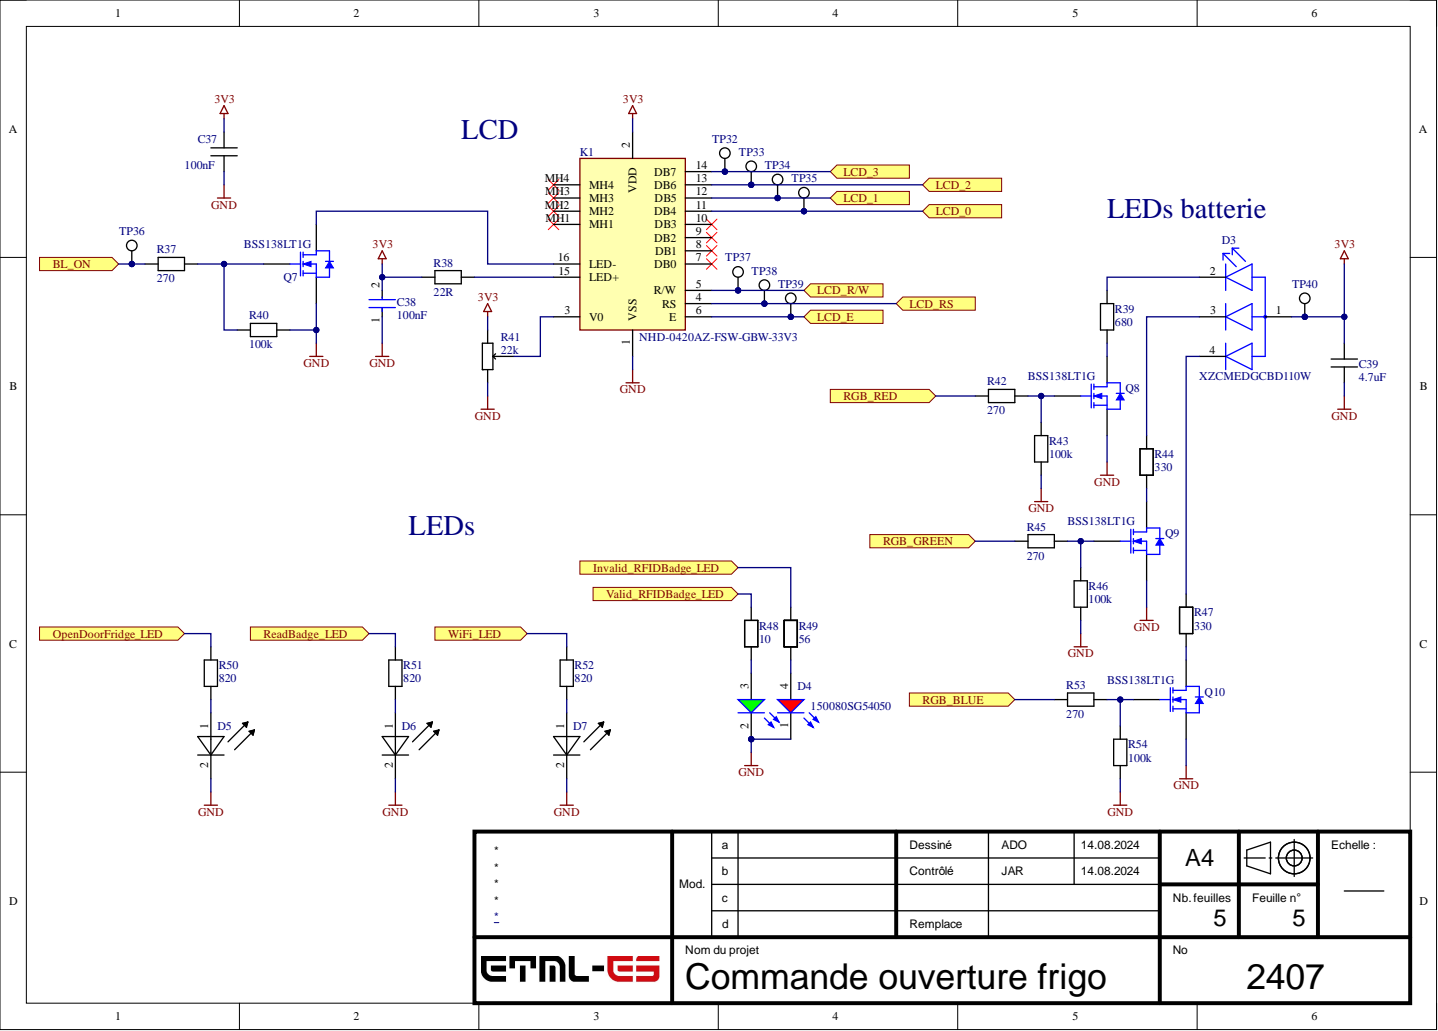
[picture p18: page 3]

* * * * * | Mod. | a | Dessiné | ADO | 14.08.2024 | A4 | | Echelle :

b | Contrôlé | JAR | 14.08.2024

c | | | | Nb. feuilles 5 | Feuille n° 5

d | Remplace

Nom du projet | | | | | No
