ETML-ES-SLO/PRJ_2407_CmdFrigo/mec/Boitier base.pdf

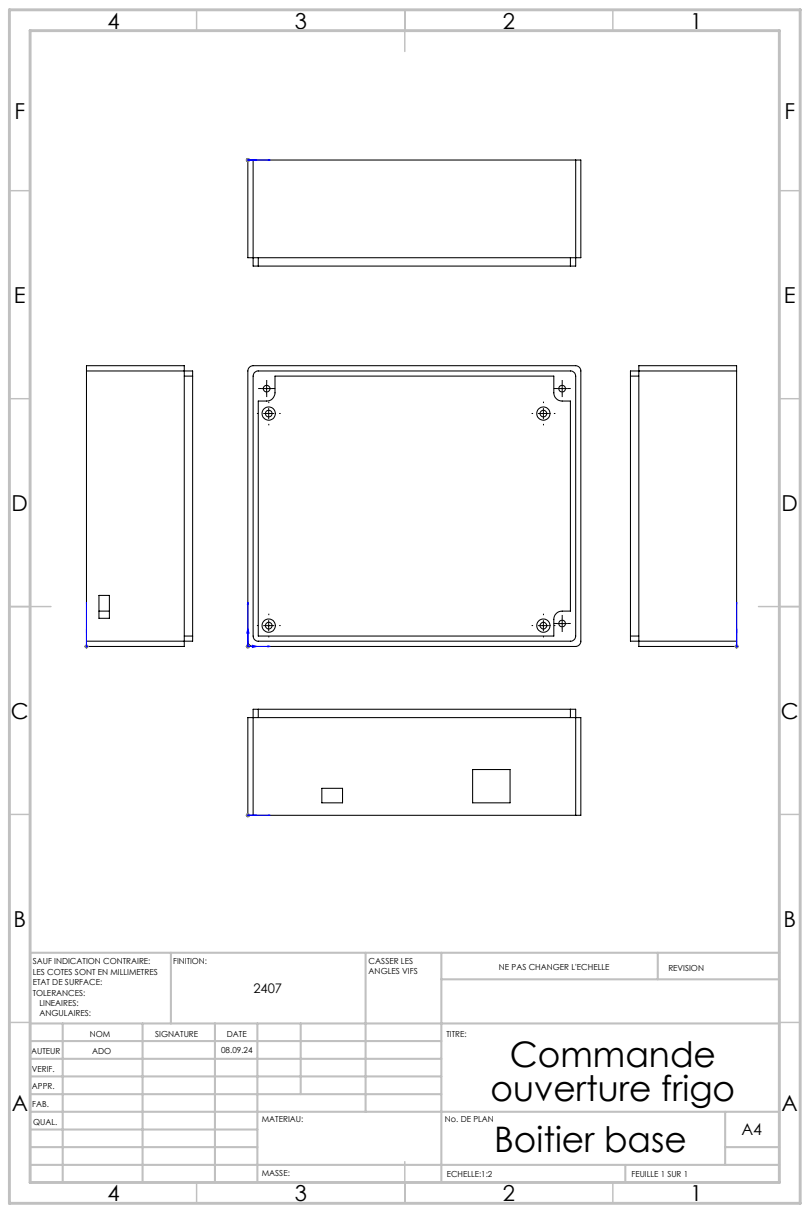
[picture p19: page 1]
FINITION:; CASSER LES; ANGLES VIFS; NE PAS CHANGER L'ECHELLE; REVISION; ECHELLE:1:2; FEUILLE 1 SUR 1

SAUF INDICATION CONTRAIRE:
LES COTES SONT EN MILLIMETRES
ETAT DE SURFACE:
TOLERANCES:
LINEAIRES:
ANGULAIRES:

NOM | SIGNATURE | DATE | | | | TITRE: Commande ouverture frigo

AUTEUR | ADO | | 08.09.24
VERIF.
APPR.
FAB.
QUAL. | | | | MATERIAU: | No. DE PLAN Boitier base | A4
